brianpalmer1321-rgb/openScadLTDEngine/(commit log)

2026-05-26 Initial commit: LTD Stirling engine OpenSCAD model.
    Add parametric assembly with Customizer modes, README, and gitignore for export artifacts.
    [LTDEngine.scad]
2026-05-26 Size displacer from can volume and fix piston/linkage kinematics.
    Derive displacer dimensions from tuna-can bore, constrain power piston travel in the cylinder, and compute connecting-rod lengths to actual pin positions.
    [LTDEngine.scad]
2026-05-26 Add outward-facing setscrew collars on crank arms for timing trim.
    Clamp collars extend only away from the web sandwich so they do not intersect the center plates.
    [LTDEngine.scad]
2026-05-26 Add parts list to README for assembly reference.
    Document printed parts, hardware, purchased items, and Individual mode export layout with OpenSCAD module names.
2026-05-26 Improve hardware mounting, print layouts, and flywheel collar setscrew.
    Replace cold-plate nut pockets with M3 heat-set insert bores, orient Individual-mode parts for flat printing, and add a radial setscrew hole on the flywheel clamping collar.
    [LTDEngine.scad]
2026-05-26 Offset crank-arm setscrew holes 90° from pin bores for assembly access.
    [LTDEngine.scad]
2026-05-26 Redesign crank linkage ends as discs and widen web plate spacing.
    Use flattened discs with center pin bores and side stick sockets, increase crank web gap for clearance, shorten shaft segments, and align disc holes with crank pins.
    [LTDEngine.scad]
2026-05-26 Use disc clevis on both linkage rod ends for consistent pin joints.
    Extract link_end_disc() and mirror the stick socket on the piston/flange end so the silver rod seats correctly at both joints.
    [LTDEngine.scad]
2026-05-26 Align displacer linkage to rod flange pin at the wrist joint.
    Target disp_rod_joint_z for link length and angle, rotate the clevis pin along X to match link_end_disc, and derive flange placement from pin offset.
    [LTDEngine.scad]
2026-05-26 Round clevis boss tops to match link_end_disc arc on piston and flange.
    Add clevis_boss_round_top() for a flat shank with a link_disc_d semicircular crown while keeping pin and tab positions unchanged.
    [LTDEngine.scad]
2026-05-26 Split crankshaft spans to clear web-plate gaps for linkage rods.
    Derive shaft lengths from crank web geometry and add short stubs through each plate so long segments no longer intersect fork clearance zones.
    [LTDEngine.scad]
2026-05-26 Add four crankshaft stiffener tubes with precise end stops.
    Tubes fill open rod spans between cranks and flywheel, butt crank and
    flywheel collar faces, meet the hub on the frame side, and stop 0.5 mm
    short of bearing housings.
    [LTDEngine.scad]
2026-05-26 Trim displacer rod flange clevis pin to clevis width.
    Drive clevis_pin_len from tab geometry for the rod_flange bore and the
    assembly silver pin so both match the fork outer faces.
    [LTDEngine.scad]
2026-05-26 Stop linkage silver rods short of pin bores in link_end_disc.
    Compute stick reach from disc rim with 0.5 mm clearance past pin OD;
    kinematic pin spacing unchanged, rod cylinder built with positive height.
    [LTDEngine.scad]
2026-05-26 Promote hardcoded dimensions to Customizer parameters and derived variables.
    Expose cylinder, layout, pin, and bearing sizing in Customizer so can geometry, cold plate, and linkage stay in sync when dimensions change.
    [LTDEngine.scad]
2026-05-27 Add thermodynamic estimates, builder cut lengths, and axle explode view.
    Echo Carnot/Schmidt efficiency and rod cut dimensions on preview, and spread crankshaft parts along X in Exploded mode.
    [LTDEngine.scad]
2026-05-27 Split cold side into plate and snap ring; deepen power piston cup.
    Separate the clamping snap ring from the cold plate for plastic tuning, and expose power_piston_h with a fixed clevis boss while scaling cylinder height for full stroke.
    [LTDEngine.scad]
2026-05-27 Export green link forks only in Individual mode and fix build plate layout.
    Omit steel rods from Individual STL export, reorganize part positions to avoid overlaps, and add interference_check.py for kinematic and bed-layout validation.
    [LTDEngine.scad]
2026-05-28 Document aluminum cold plate and strengthen snap ring clamp lip.
    Render the cold plate as silver, list it as machined aluminum in the README, fix clamp hook geometry with ring_clamp_inner_d, and drop Individual bed-layout checks from interference_check.
    [LTDEngine.scad]
2026-05-28 Add export_part dropdown for Individual-mode STL export.
    One Customizer choice exports a single part at the origin or the full plate layout, so each STL export is straightforward without manual hiding.
    [LTDEngine.scad]
2026-05-28 Add cold_plate_cup_depth for cooling water dish on cold plate.
    Expose the snap-ring rim overlap as a Customizer parameter, mill a matching top dish inside the clamp hook, and nudge axle-to-deck and frame standoff positions.
    [LTDEngine.scad]
2026-05-28 Close kinematic loop with fixed power link and displacer shaft lengths.
    Derive rod lengths from nominal crank geometry and solve piston/displacer positions from slider-crank constraints so animation matches rigid steel parts; sync interference_check.py.
    [LTDEngine.scad]
2026-05-29 Add 401 can reference model and DXF-driven TPU snap ring.
    Can401.scad documents industry 401 rim geometry and snap-over lid fit; the engine snap ring now revolves the synced DXF profile with Y-section preview and updated docs.
    [Can401.scad, LTDEngine.scad]
2026-05-29 Improve Can401 snap lid fit and section view.
    Derive skirt clearance from seam OD, align the bead with the seam base, add a press-on chamfer below the bead, and support per-part Y-section colors.
    [Can401.scad]
2026-05-29 Simplify Can401 Y-section and use opaque part colors.
    Remove per-part section cap colorization and partial alpha so the can and lid render as solid Silver and Teal.
    [Can401.scad]
2026-05-30 Integrate Can401 into LTDEngine and remove unused snap-ring calcs.
    Extract Can401_lib.scad for shared geometry, swap the hot cylinder to can401_body(), retune bore/displacer dims for the 401 can, and drop legacy groove variables that the DXF profile replaced.
    [Can401.scad, Can401_lib.scad, LTDEngine.scad]
2026-05-30 Replace DXF snap ring with 401 lid-skirt parametric profile.
    Add can401_engine_snap_ring to Can401_lib using the lid skirt bead grip plus a cold-plate hook, and add DXF export tools for body and ring meridional sections.
    [Can401_lib.scad, LTDEngine.scad]
2026-05-30 Size cold plate to 401 can mouth and seat it on the inner rim.
    Derive plate OD from can mouth ID minus rim clearance, lower the plate by cold_plate_drop until its edge contacts the rolled rim, and keep frame mounts and power cylinder aligned with the seated position.
    [Can401_lib.scad, LTDEngine.scad]
2026-06-01 Add wedge snap ring profile and restore brass seal tube in assembly.
    Replace the flipped plate-hook ring with a seated rim wedge plus lid-skirt grip, align the DXF exporter, and show the brass tube through the cold plate bore.
    [Can401_lib.scad, LTDEngine.scad]
2026-06-05 Fix support frames to mount on cold-plate deck top.
    Redefine axle_to_deck as crank-to-plate-top distance, refactor support_frame
    to local coords with feet on the deck, and replace mid-plate slots with
    top-down bolt holes. Sync interference_check Z stack and document the
    displacer shaft length change.
    [LTDEngine.scad]
2026-06-06 Add T-foot support frames to avoid cold-plate frame holes.
    Mount each frame via M3 screws into printed end feet so the aluminum deck stays unperforated for sealing.
    [LTDEngine.scad]
2026-06-06 Include cold-plate gas passage in Schmidt dead-volume estimate.
    Count power-cylinder bore through the deck in V_c0 and echo the passage volume separately for clearer thermodynamic output.
    [LTDEngine.scad]
2026-06-06 Stop linkage rods short of pin bores in link_end_disc.
    Restore geometry-derived stick reach so silver rods and disc bores no longer intersect clevis pins; sync builder cut lengths.
    [LTDEngine.scad]
2026-08-10 Flip snap ring onto the can rim and adopt thinner cold-plate defaults.
    Orient the TPU ring with a Z flip and tuned ring_z_offset, tighten plate rim clearance/thickness, and keep Fusion/interference tools in sync; also refine power-piston cup and clevis geometry.
    [LTDEngine.scad, ringTest.scad]
2026-08-10 Make snap ring printable and tune clamp fit on the cold plate.
    Add a mouth hold-down shelf with dual 45° bead for support-free upside-down printing, thicken the outer wall, and sync Customizer defaults from tuned JSON.
    [Can401_lib.scad, LTDEngine.scad, ringTest.scad]
2026-08-11 Add snap-ring diameter adjuster and zero Customizer offsets.
    Expose ring_diameter_adjust for looser can snap-over fit, bake prior bead/OD/Z tunes into hidden baselines, and keep other Customizer deltas at zero.
    [Can401_lib.scad, LTDEngine.scad]
2026-08-14 Add displacer foam cutter and shaft hole for printed displacers.
    Standalone OpenSCAD rotary cutter matches displacer OD; Individual mode
    exports a displacer with a friction-fit rod bore.
    [LTDEngine.scad, displacerFoamCutter.scad]
